fulviomanente/IQRight_Local/configs/requirements.repeater.txt

# IQRight LoRa Repeater Requirements
# Node Type: Repeater (Node ID: 200-256)
# Application: repeater.py

# Core dependencies
python-dotenv>=1.0.0

# LoRa hardware (Raspberry Pi only)
adafruit-circuitpython-rfm9x>=2.2.0
adafruit-blinka>=8.0.0

# OLED display (optional, Raspberry Pi only)
adafruit-circuitpython-ssd1306>=2.12.0
pillow>=10.0.0

# GPIO for Waveshare Power Management HAT shutdown listener
RPi.GPIO>=0.7.1

# I2C for PiSugar 3 battery monitor (reads battery via I2C address 0x57)
smbus>=1.1.post2
