fulviomanente/IQRight_Local/3d_models/BLE/box_V5/Part-three 2.stl

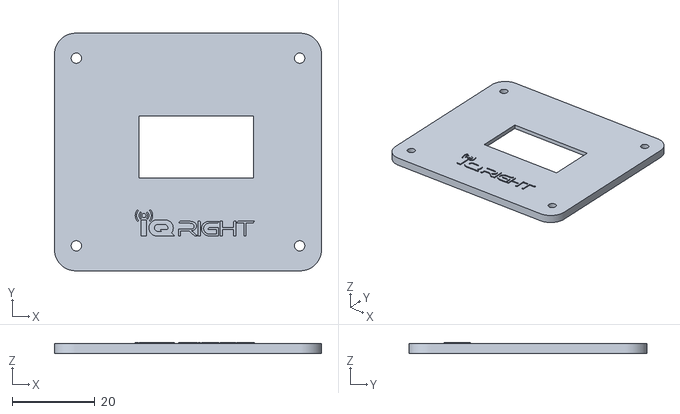
[picture p1: CAD file, 2026-04-21]
3d_models/BLE/box_V5/Part-three 2.stl
64.5 x 57.4 x 2.76
