fulviomanente/IQRight_Local/3d_models/Repeater/repeater_brackets.stl

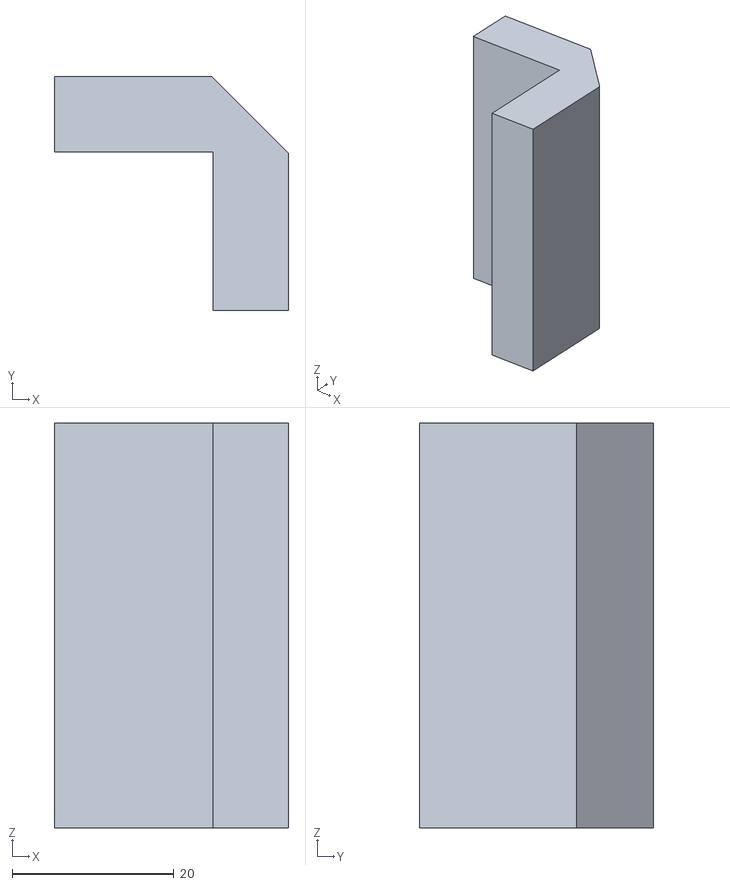
[picture p2: CAD file, 2026-04-21]
3d_models/Repeater/repeater_brackets.stl
28.9 x 28.9 x 50.0
