fulviomanente/IQRight_Local/3d_models/Scanner/v1-5_inch_Screen/mango partte 1.stl

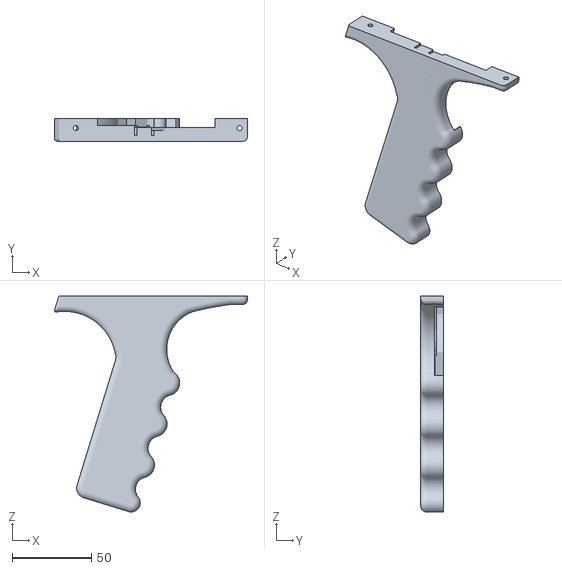
[picture p3: CAD file, 2026-04-21]
3d_models/Scanner/v1-5_inch_Screen/mango partte 1.stl
121.9 x 14.4 x 136.4
