fulviomanente/IQRight_Local/3d_models/Scanner/V7 (Scanner_Green)/box.stl

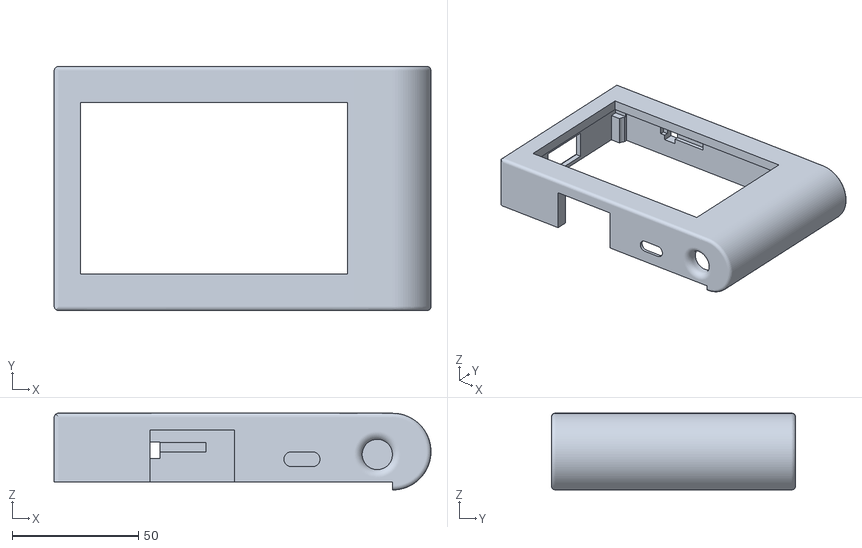
[picture p4: CAD file, 2026-04-21]
3d_models/Scanner/V7 (Scanner_Green)/box.stl
149.5 x 96.9 x 30.5
