fulviomanente/IQRight_Local/3d_models/Scanner/V8/bottom_8.stl

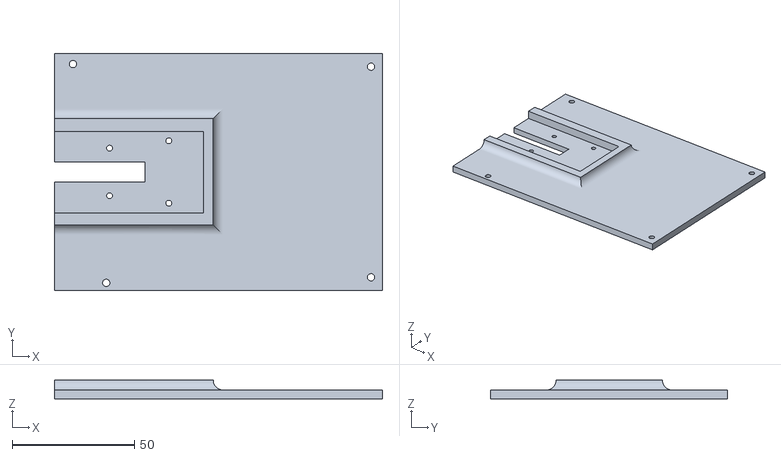
[picture p5: CAD file, 2026-04-23]
3d_models/Scanner/V8/bottom_8.stl
134.3 x 96.9 x 7.62
