fulviomanente/IQRight_Local/3d_models/Repeater/repeater_lid.stl

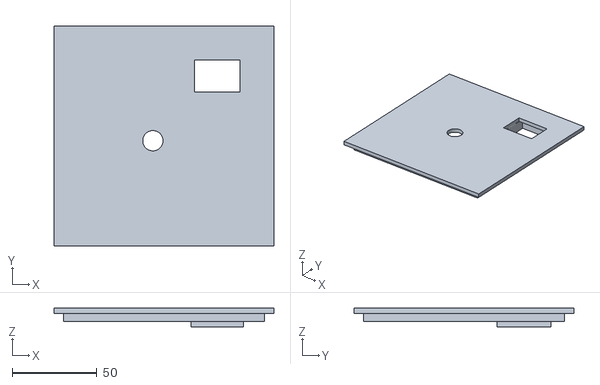
[picture p6: CAD file, 2026-04-21]
3d_models/Repeater/repeater_lid.stl
130.0 x 130.0 x 11.0
