fulviomanente/IQRight_Local/3d_models/Scanner/V8/top_internal_antenna.stl

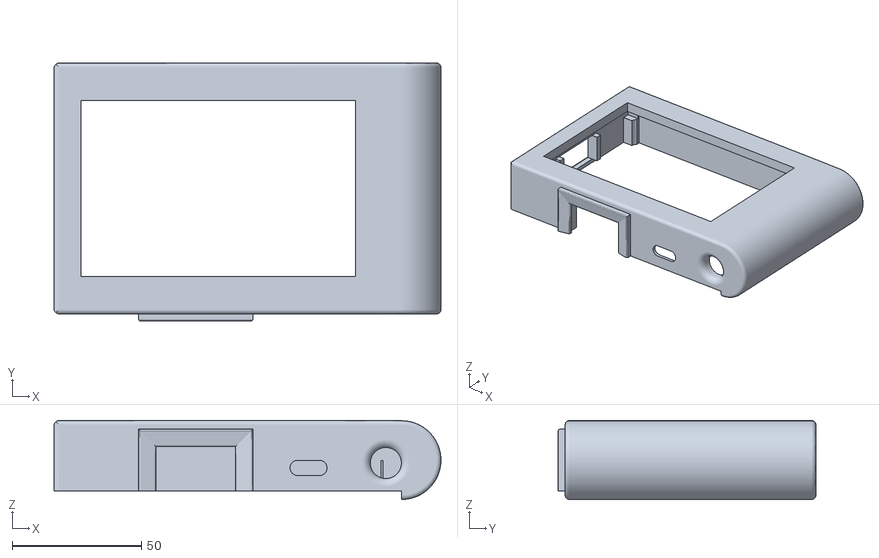
[picture p7: CAD file, 2026-04-23]
3d_models/Scanner/V8/top_internal_antenna.stl
149.5 x 99.6 x 30.5
