fulviomanente/IQRight_Local/3d_models/Repeater/repeater_base_plate.stl

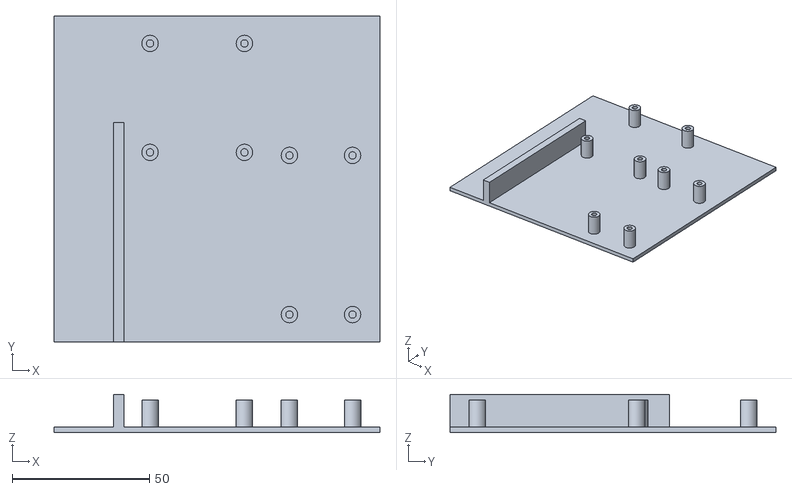
[picture p8: CAD file, 2026-04-21]
3d_models/Repeater/repeater_base_plate.stl
118.8 x 118.8 x 14.0
