fulviomanente/IQRight_Local/3d_models/Scanner/v1-5_inch_Screen/cajasuperior.stl

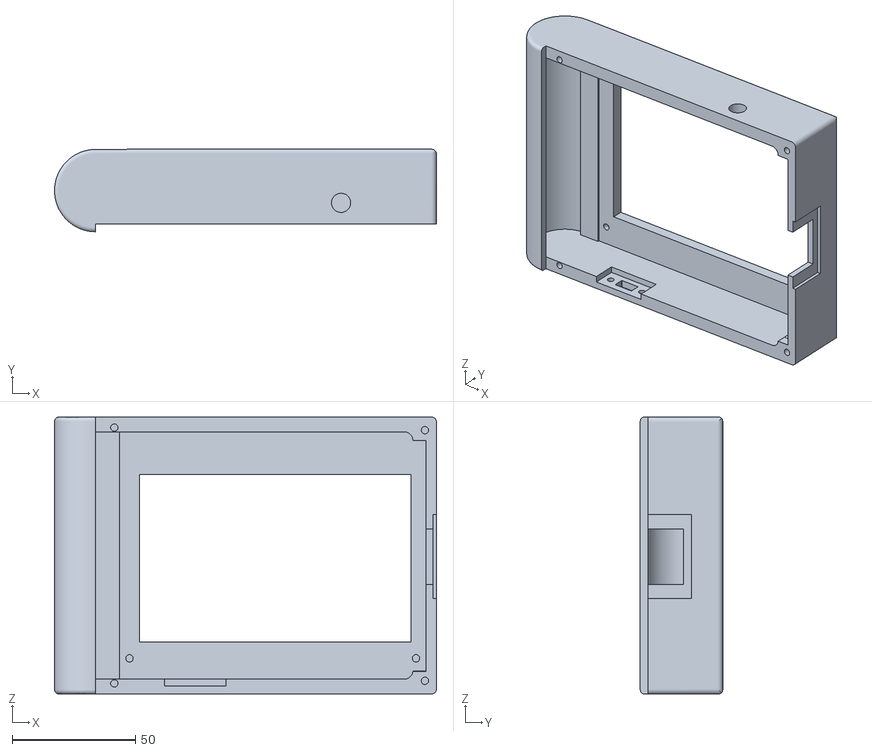
[picture p9: CAD file, 2026-04-21]
3d_models/Scanner/v1-5_inch_Screen/cajasuperior.stl
155.1 x 33.5 x 112.4
