fulviomanente/IQRight_Local/3d_models/Scanner/V8/bottom_8.2_cable_connector.stl

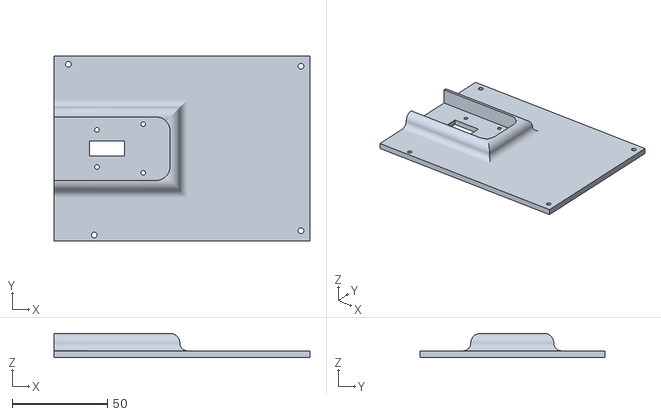
[picture p10: CAD file, 2026-04-23]
3d_models/Scanner/V8/bottom_8.2_cable_connector.stl
134.3 x 96.9 x 12.7
