fulviomanente/IQRight_Local/3d_models/BLE/box_V5/Part-two-wrong 2.stl

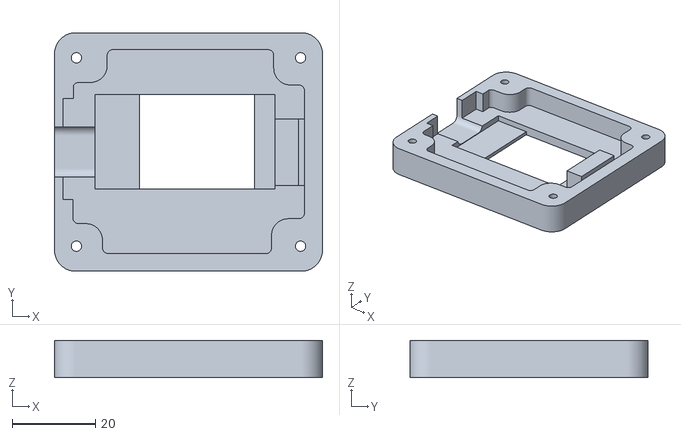
[picture p11: CAD file, 2026-04-21]
3d_models/BLE/box_V5/Part-two-wrong 2.stl
64.5 x 57.4 x 9.00
