fulviomanente/IQRight_Local/3d_models/Repeater/repeater_box.stl

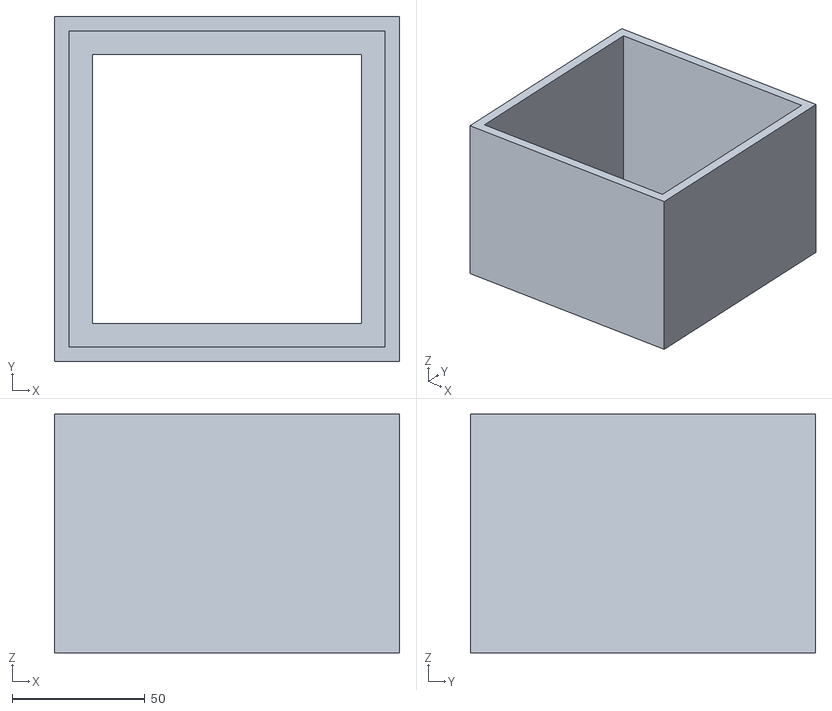
[picture p12: CAD file, 2026-04-21]
3d_models/Repeater/repeater_box.stl
130.0 x 130.0 x 90.0
