fulviomanente/IQRight_Local/3d_models/Scanner/v1-5_inch_Screen/cajabase-2.stl

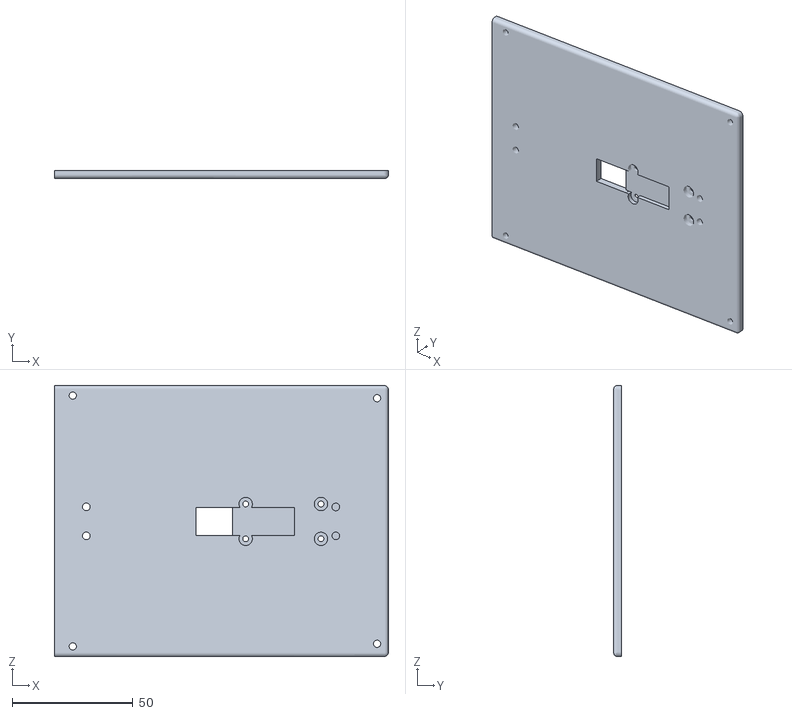
[picture p13: CAD file, 2026-04-21]
3d_models/Scanner/v1-5_inch_Screen/cajabase-2.stl
138.4 x 3.23 x 112.4
