fulviomanente/IQRight_Local/3d_models/Scanner/V8/handle_right.stl

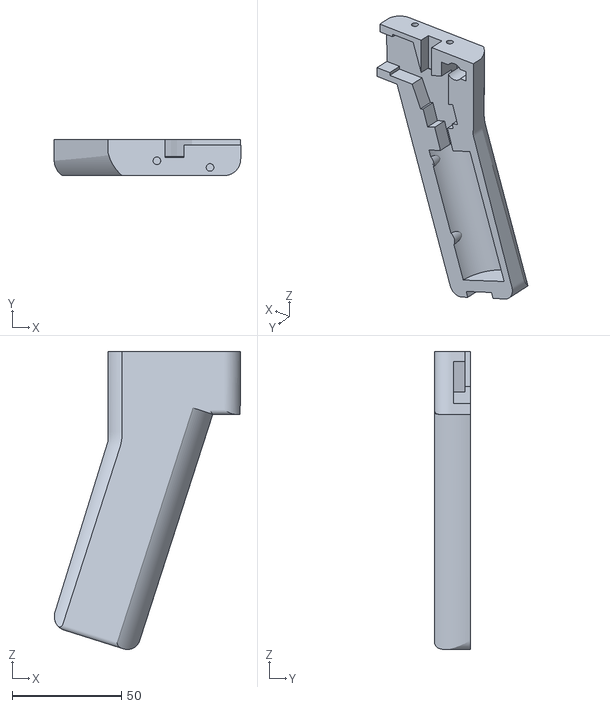
[picture p14: CAD file, 2026-04-21]
3d_models/Scanner/V8/handle_right.stl
85.2 x 16.5 x 136.1
