fulviomanente/IQRight_Local/3d_models/Scanner/V8/handle_left.stl

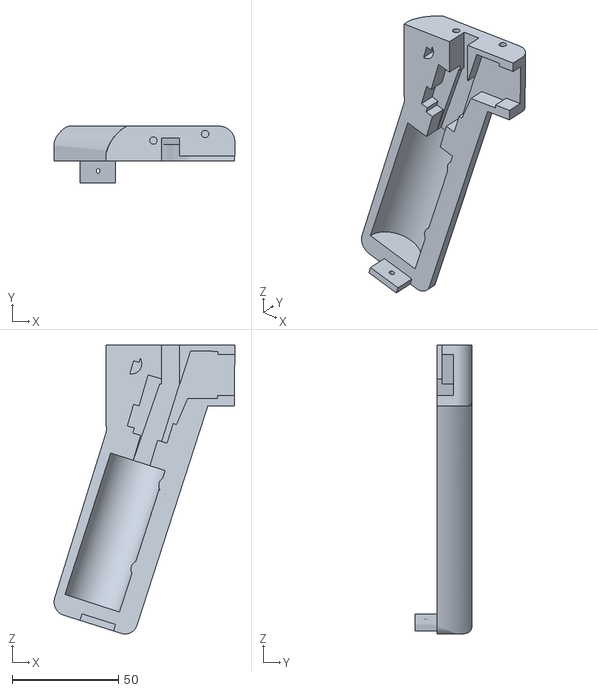
[picture p15: CAD file, 2026-04-21]
3d_models/Scanner/V8/handle_left.stl
85.2 x 26.7 x 136.1
