fulviomanente/IQRight_Local/3d_models/BLE/box_V5/Part-one.stl

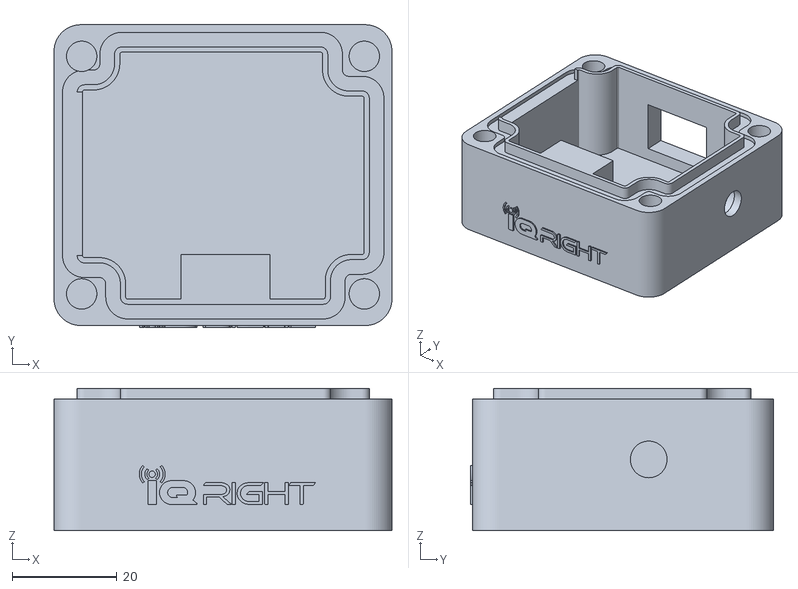
[picture p16: CAD file, 2026-04-21]
3d_models/BLE/box_V5/Part-one.stl
64.5 x 57.7 x 27.2
