fulviomanente/IQRight_Local/(list of files, cad)

Other CAD files:
3d_models/BLE/box_V5/Part-three-wrong.stl
3d_models/Scanner/v1-5_inch_Screen/mango partte 2.stl
3d_models/Scanner/V8/bottom_8.1-cable_open.stl
3d_models/BLE/box_V5/Part-three-wrong 2.stl
3d_models/Scanner/V8/top.stl
3d_models/BLE/box_V5/Part-two 2.stl
3d_models/BLE/box_V5/Part-two.stl
3d_models/BLE/box_V1/part1.stl
3d_models/BLE/box_V1/part2.stl
3d_models/BLE/box_V1/part3.stl
3d_models/BLE/box_V2/Part-one.stl
3d_models/BLE/box_V2/Part-three.stl
3d_models/BLE/box_V2/Part-two-old.stl
3d_models/BLE/box_V2/Part-two.stl
3d_models/BLE/box_V3/Part-one.stl
3d_models/BLE/box_V3/Part-three.stl
3d_models/BLE/box_V3/Part-two.stl
3d_models/BLE/box_V4/Part-one.stl
3d_models/BLE/box_V4/Part-three.stl
3d_models/BLE/box_V4/Part-two.stl
3d_models/BLE/box_V4/Part-two_old.stl
3d_models/Scanner/V2.0/cajabase 2.stl
3d_models/Scanner/V2.0/cajasuperior 2.stl
3d_models/Scanner/V2.0/mango partte 1.stl
3d_models/Scanner/V2.0/mango partte 2.stl
3d_models/Scanner/V2.0/old/cajabase 2.stl
3d_models/Scanner/V2.0/old/cajasuperior 2.stl
3d_models/Scanner/V2.0/old/mango partte 1.stl
3d_models/Scanner/V2.0/old/mango partte 2.stl
3d_models/Scanner/V2.0/old/trigger.stl
3d_models/Scanner/V2.0/trigger.stl
3d_models/Scanner/V3.0/mango partte 1.stl
3d_models/Scanner/V3.0/mango partte 2.stl
3d_models/Scanner/V4.0/acabado caja superior.stl
3d_models/Scanner/V4.0/cajabase 2.stl
3d_models/Scanner/V4.0/cajasuperior 2.stl
3d_models/Scanner/V4.0/mango partte 1.stl
3d_models/Scanner/V4.0/mango partte 2.stl
3d_models/Scanner/V4.0/trigger.stl
3d_models/Scanner/V5.0/cajasuperior 2.stl
3d_models/Scanner/V5.0/mango partte 1.stl
3d_models/Scanner/V5.0/mango partte 2.stl
3d_models/Scanner/V5.0/trigger 2.stl
3d_models/Scanner/V5.1/cajabase 2.stl
3d_models/Scanner/V5.1/cajasuperior 4.stl
3d_models/Scanner/V5.1/trigger 3.stl
3d_models/Scanner/V6.0/Box.stl
3d_models/Scanner/V6.0/Box_with_Visor.stl
3d_models/Scanner/V6.0/Handle_Left.stl
3d_models/Scanner/V6.0/Handlle_Right.stl
3d_models/Scanner/V6.0/lid.stl
3d_models/Scanner/V6.0/scanner_lid.stl
3d_models/Scanner/V6.0/trigger.stl
