fulviomanente/IQRight_Local/3d_models/Scanner/V2.0/Cambios.pdf

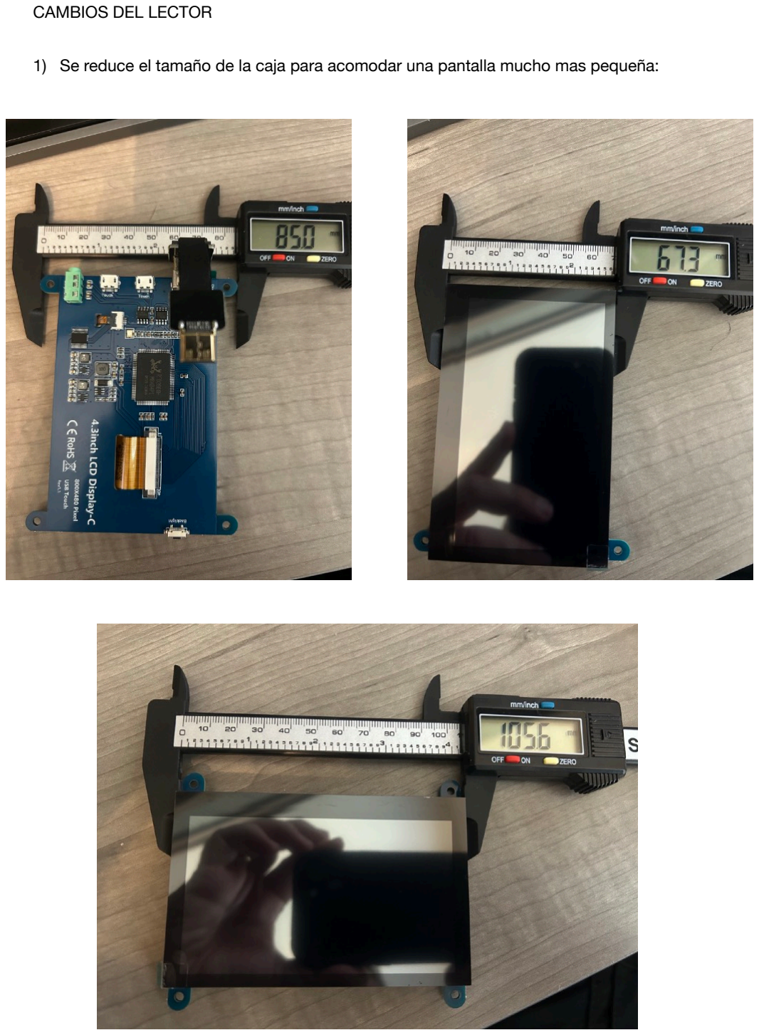
[picture p17: page 1]

CAMBIOS DEL LECTOR

1) Se reduce el tamaño de la caja para acomodar una pantalla mucho mas pequeña:

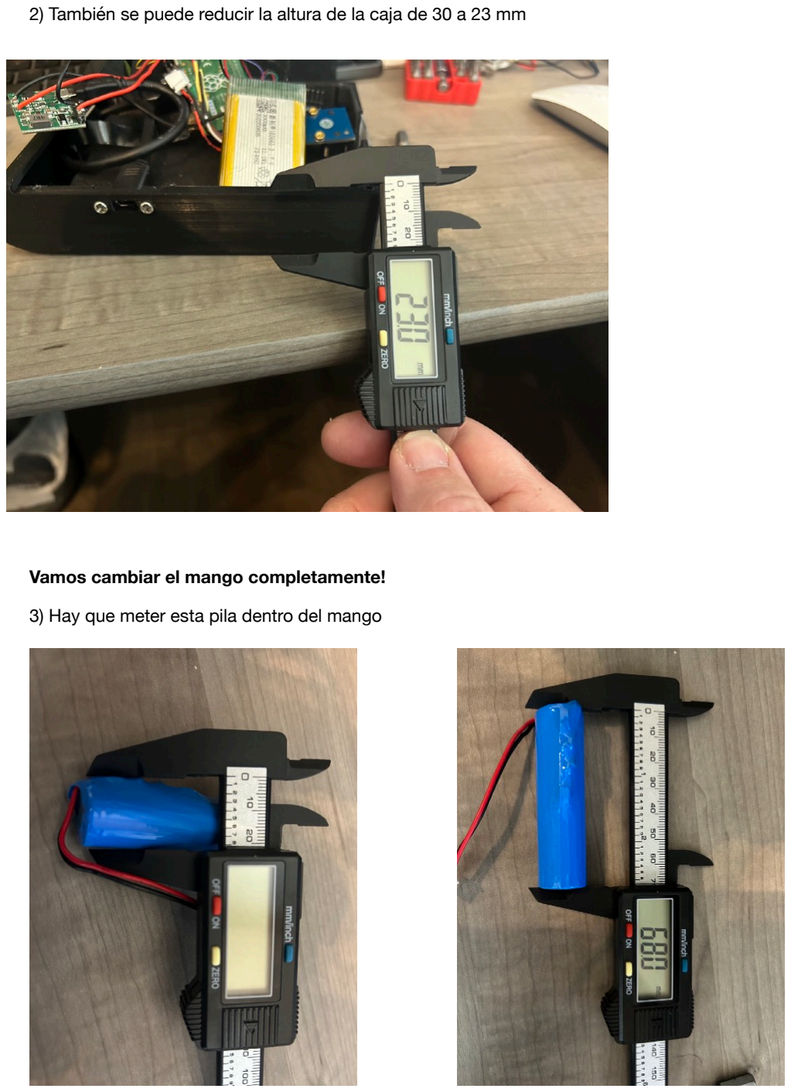
[picture p18: page 2]

2) También se puede reducir la altura de la caja de 30 a 23 mm

Vamos cambiar el mango completamente!

3) Hay que meter esta pila dentro del mango

4) Para eso, subimos el switch 22mm hacia arriba, como en la foto

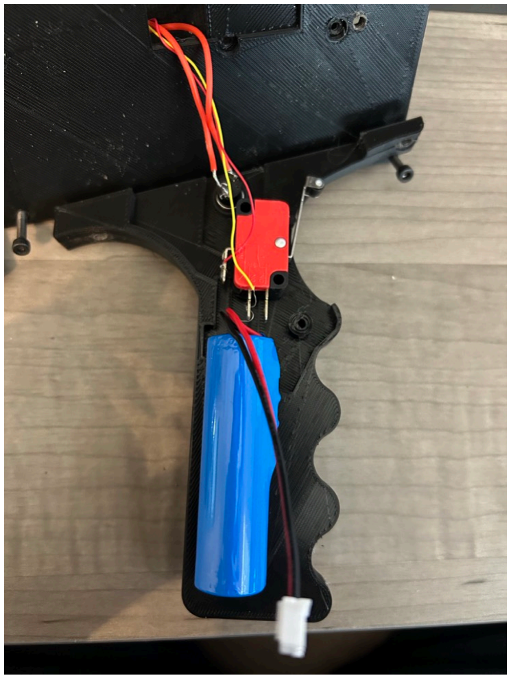
[picture p19: figure]
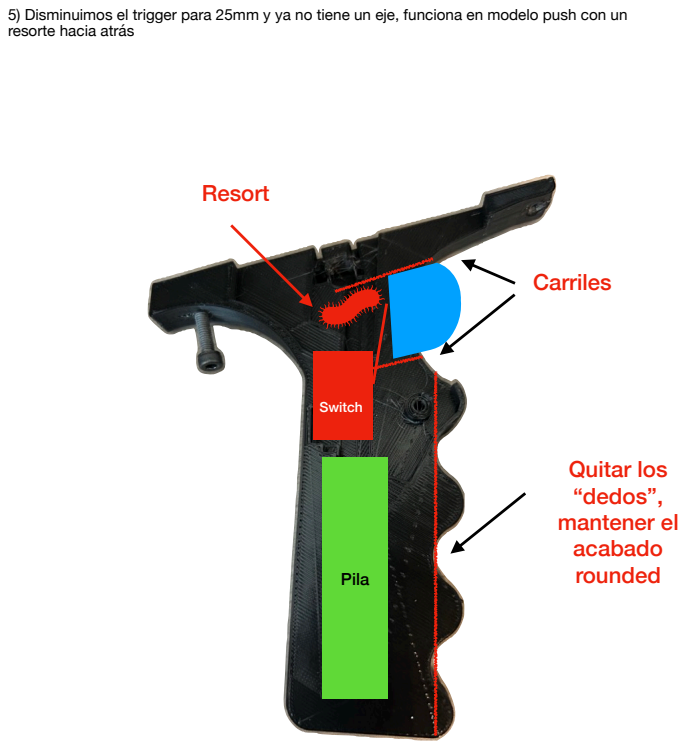
[picture p20: page 4]
Switch; Pila; Carriles; Resort; Quitar los “dedos”, mantener el acabado rounded

5) Disminuimos el trigger para 25mm y ya no tiene un eje, funciona en modelo push con un
resorte hacia atrás

6) Cambiemos la forma de meter los tornillos en la caja para los lados y la parte de atrás (si necesario) la caja sera mucho menor y necesitamos el espacio adelante para que el lector sea externo, como el item 7

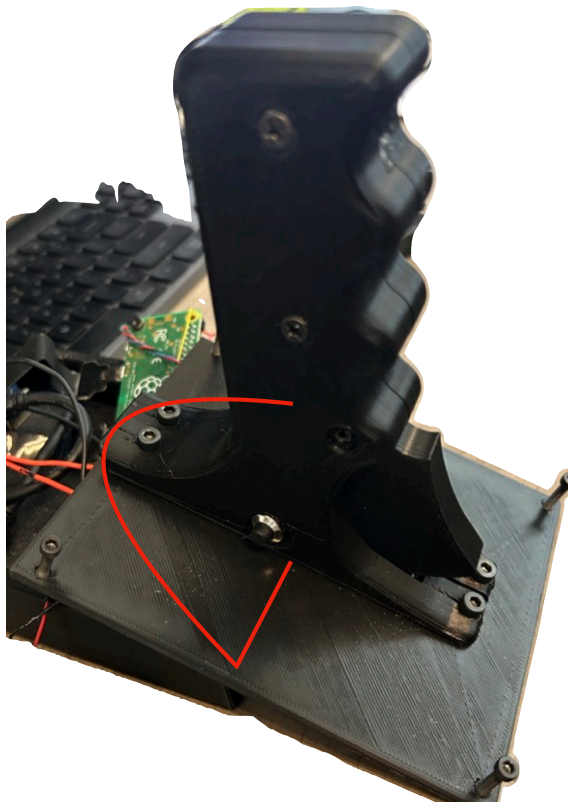
[picture p21: figure]

7) El lector tiene que estar en un recorte "para fuera”de la caja principal. Aquí un dibujo de la idea

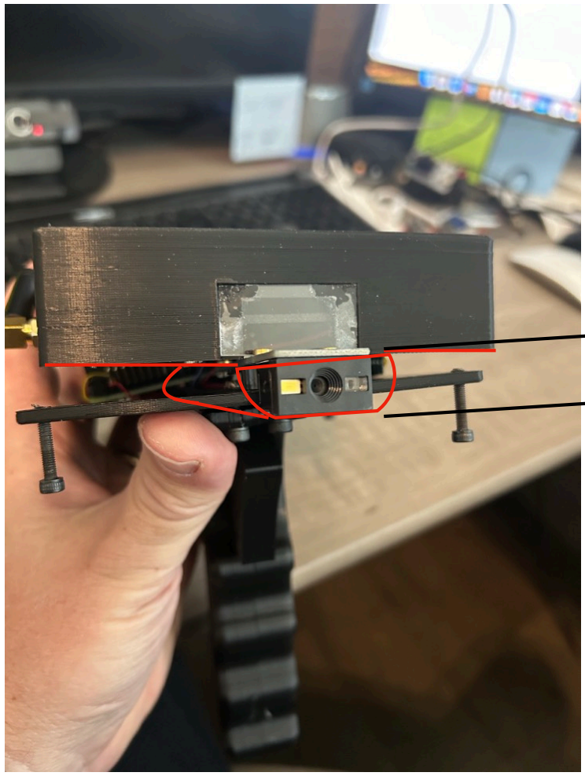
[picture p22: figure]

14 mm

33 mm de ancho
40mm de profundidad
