fulviomanente/IQRight_Local/configs/config.server.py

import os

# Project Configuration
PROJECT_ID = 'iqright'
SECRET_KEY = 'iqrightapp_secret'
SECURITY_PASSWORD_SALT = 'iqrightapp_salt'
DEBUG = True

# LOGGING Configuration
LOG_FILENAME = "IQRight_Server.debug"
MAX_LOG_SIZE = 20 * 1024 * 1024  # 20Mb
BACKUP_COUNT = 10

# Offline Data Configuration
OFFLINE_USERS_FILENAME = 'offline_users.iqr'
OFFLINE_FULL_LOAD_FILENAME = 'full_load.iqr'
LOCAL_FILE_VERSIONS = 'local_file_versions.json'
FILE_DTYPE = {
    'ChildID': int, 'IDUser': int, 'FirstName': str, 'LastName': str, 'AppIDApprovalStatus': int,
    'AppApprovalStatus': str, 'DeviceID': str, 'Phone': str, 'ChildName': str, 'ExternalNumber': str,
    'HierarchyLevel1': str, 'HierarchyLevel1Type': str, 'HierarchyLevel1Desc': str,
    'HierarchyLevel2': str, 'HierarchyLevel2Type': str, 'HierarchyLevel2Desc': str,
    'StartDate': str, 'ExpireDate': str, 'IDApprovalStatus': int, 'ApprovalStatus': str,
    'MainContact': int, 'Relationship': str, 'IDHierarchy': int, 'ClassCode': str
}

# API Configuration
API_ENABLED = os.getenv('API_ENABLED', 'FALSE') == 'TRUE'
API_TIMEOUT = float(os.getenv('API_TIMEOUT', '10.0'))
LOOKUP_TIMEOUT = float(os.getenv('LOOKUP_TIMEOUT', '2.0'))  # Overall timeout for getInfo()
if os.getenv('DEBUGSERVICE', 'FALSE') == 'TRUE':
    API_URL = 'http://127.0.0.1:5001/api/'
else:
    API_URL = 'https://integration.iqright.app/api/'

if os.getenv('LOCAL', None) == 'TRUE':
    LORASERVICE_PATH = './data'
    LORASERVICE_LOG_PATH = './log/Server.log'
    HOME_DIR = '.'
    WEBAPP_LOG_DIR = './log'
else:
    LORASERVICE_PATH = '/etc/iqright/LoraService'
    LORASERVICE_LOG_PATH = '/etc/iqright/LoraService/LoraService.log'
    HOME_DIR = '/etc/iqright/LoraService'
    WEBAPP_LOG_DIR = '/etc/iqright/WebApp/logs'

# MQTT Configuration
TOPIC_PREFIX = 'Class'
TOPIC = ''
MQTT_BROKER = 'localhost'
MQTT_PORT = 1883
MQTT_USERNAME = 'iqright'
MQTT_TRANSPORT = 'tcp'
MQTT_VERSION = '5'
MQTT_KEEPALIVE = 60

# LORA Configuration (Legacy - kept for backwards compatibility)
RFM9X_FREQUENCE = 915.23
RFM9X_TX_POWER = 23
RFM9X_NODE = 1
RFM9X_ACK_DELAY = 0.1
RFM9X_SEND_DELAY = 0.3
RMF9X_POOLING = 0.9

# Enhanced LoRa Packet Configuration
LORA_NODE_TYPE = os.getenv('LORA_NODE_TYPE', 'SERVER')
LORA_NODE_ID = int(os.getenv('LORA_NODE_ID', '1'))  # Server is always node 1
LORA_FREQUENCY = float(os.getenv('LORA_FREQUENCY', '915.23'))  # MHz
LORA_TX_POWER = int(os.getenv('LORA_TX_POWER', '23'))  # dBm
LORA_TTL = int(os.getenv('LORA_TTL', '3'))  # Max hops for repeater
LORA_ENABLE_CA = os.getenv('LORA_ENABLE_CA', 'TRUE') == 'TRUE'  # Collision avoidance
LORA_CA_MIN_DELAY_MS = int(os.getenv('LORA_CA_MIN_DELAY_MS', '10'))
LORA_CA_MAX_DELAY_MS = int(os.getenv('LORA_CA_MAX_DELAY_MS', '100'))
LORA_RX_GUARD_MS = int(os.getenv('LORA_RX_GUARD_MS', '50'))

# Grade Restriction Configuration
# Grades that are restricted during normal car line operation
# These students will NOT be sent to the scanner unless today is an unrestricted date
RESTRICTED_GRADES = ['7th', '8th']
# Dates when restricted grades ARE allowed (format: 'YYYY-MM-DD')
# Example: ['2026-02-14', '2026-05-23']
UNRESTRICTED_DATES = []

# IQRight Configuration
IDFACILITY = 1
BEACON_LOCATIONS = {
    102: {"device": "QR Reader", "location": "Gym Side"},
    103: {"device": "QR Reader", "location": "Gym Side"},
    104: {"device": "QR Reader", "location": "West Side"},
    201: {"device": "Repeater", "location": "Gym Side"},
    202: {"device": "Repeater", "location": "West Side"},
    2: {"device": "QR Reader", "location": "East Side"},
    3: {"device": "BLE Reader","location": "East Side"}}
