fulviomanente/IQRight_Local/(commit log)

2025-01-30 Additional fixes to download the full_load.csv from GCS via API
    [mqtt_grid_web.py]
2025-02-01 new Commit to bypass json file problem
    [mqtt_grid_web.py]
2025-02-08 feat: add offline data handling with versin control
    - Add offline user authentication and data storage
    - Improve error handling and logging
    - Add version control for offline files
    [config.py, mqtt_grid_web.py]
2025-02-08 feat: load IDHierarchy from offline data
    - Fix file download error
    - Implement local data lookup with adding HierarchyID to payload on CaptureLora.py
    - Implement dynamic topic using HierarchyID on CaptureLora.py
    [CaptureLora.py]
2025-02-10 feat: add MQTT and LoRa integration with error handling
    - Add MQTT broker configuration and client setup and LoRa module initialization and communication to config.py
    - Add error handling for API timeouts and MQTT connection failures
    - Update requirements.txt with new dependencies
    - Configure logging for both services
    [CaptureLora.py, config.py, mqtt_grid_web.py]
2025-04-16 Fix MQ Listener, adjust config.py for local service layer and change load_queue.sh test script
    [config.py, mqtt_grid_web.py]
2025-04-18 Fix multiple class codes for user, fix login structure for errors
    [mqtt_grid_web.py]
2025-04-18 working on fixing the in memory list issue. Code not finished
    [mqtt_grid_web.py]
2025-04-18 Fix tables to display students correctly after release, fix sound playing, add new services to retrieve sound or generate locally, added sleep to the load queue to be able to see the blinking and hea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
    [mqtt_grid_web.py]
2025-04-23 Fix session specific messages isolating MQTT listeners and socket io by user and centralize commands on IQRSend queue bradcasting to all users at once
    [mqtt_grid_web.py]
2025-05-01 Fix session positioning on the grids. MQ methods and Java
    [mqtt_grid_web.py]
2025-09-03 fix multi user. Bug on session ID for socketIO
    [mqtt_grid_web.py]
2025-10-13 Checking in the new approach with consolidated lora methods and colision avoidance
    [collision_avoidance.py, encrypt_teachers.py, node_types.py, packet_handler.py, repeater.py, test_api.py, test_async_lookup.py, test_crc_validation.py]
2025-10-14 Setup scripts for the repeater to the a service and a scrips that provide stats. Also imlemented a battery ready method and put the information on the display
2026-02-10 change log structure to remove noise
    [CaptureLora.py]
2026-02-11 small fixes for scanner and server during final round of tests
    [pisugar.py]
2026-02-11 Restriction for 7th and 8th grades via config and avoid conflict when playing sounds in multiple classrooms
    [CaptureLora.py, config.py, config.server.py, mqtt_grid_web.py]
2026-02-12 Adding repeater capability to send healthcheck data and battery to server
2026-02-12 Change logs and add utility to track lost packages
2026-02-18 Change server lookup to eliminate the need to convert HierarchyID in teacher, fixed beacon lookup, added option to bypass online API on the server. Eliminate teacher lookup, insert car control number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
    [CaptureLora.py, config.py, config.server.py]
2026-02-25 Setup script for server, fix all paths so both servers applications share the same files. Default 77% for the user pages, cache API username and password
    [CaptureLora.py, RMF_WiringTest.py, config.scanner.py, lora_diagnostic_script.py]
2026-02-25 fix all paths so both server apps work off of one single file, added thread that updated the info once a day, fixed the queueing process if there are messages before teachers log in
    [CaptureLora.py, mqtt_grid_web.py]
2026-03-02 Fix updating file at startup process, add console for debuggin location, add car index and remove line count from scanner_queue.py
    [lora_advanced_test.py, mqtt_grid_web.py]
2026-03-03 Checking in scanne bundle script, log fixes for the scanner, and script to generate the dictionary files for pocketsphinx
    [students_26-03-03.csv]
2026-03-05 Scanner setup process, fixes to logoff users and reset session on mqtt_grid_web for next day usage. New scanner feature to look for students done on scanner_search.py
    [CaptureLora.py, config.py, matching_engine.py, mqtt_grid_web.py, scanner_search.py]
2026-04-15 new build for repeater, added lora validation scripts, repeater working with Pisugar and Waveshare power management modules, statistics being sent from repeater to server
2026-04-16 new build for repeater, added lora validation scripts, repeater working with Pisugar and Waveshare power management modules, statistics being sent from repeater to server. Fixed the process to build 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
    [collision_avoidance.py, oled_display.py, packet_handler.py, repeater.py]
2026-04-21 3d models for repeater box and new script to create validation file for scanner
    [repeater_base_plate.stl, repeater_box.stl, repeater_brackets.stl, repeater_lid.stl, students.csv]
2026-04-21 Scanner cache by device on server
2026-04-21 New scanner app that does validation and regular scanning on the same app. Fixed hardcoded NODE ID on scanner app
    [matching_engine.py, scanner_multi.py]
2026-04-21 check in 3d Files
    [Box.stl, Box_with_Visor.stl, Handle_Left.stl, Handlle_Right.stl, Part-one 2.stl, Part-one.stl, Part-three 2.stl, Part-three-wrong 2.stl]
2026-04-21 guarantee the oled will be shutdown when the system is shutdown to avoid using too much battery
    [repeater.py]
2026-04-21 reorg repo file structure
    [deleted_linkeage.csv, teachers.csv]
2026-04-23 adjust server for self healing when booting and message to repeater + log rotation on MQTT
    [base.stl]
2026-04-23 new scanner box 3D
    [bottom_8.1-cable_open.stl, bottom_8.2_cable_connector.stl, bottom_8.stl, top_internal_antenna.stl]
2026-04-24 changes to prevent data loss on logs and to only display errors on the grid in validation mode
    [scanner_multi.py, scanner_search.py]
2026-04-24 repeater diagram with waveshare power management
2026-04-24 switch do turn display on and off
